ngc6589/arduinoMidiSynthPSG/Photos/20211010_050321084_iOS.jpg

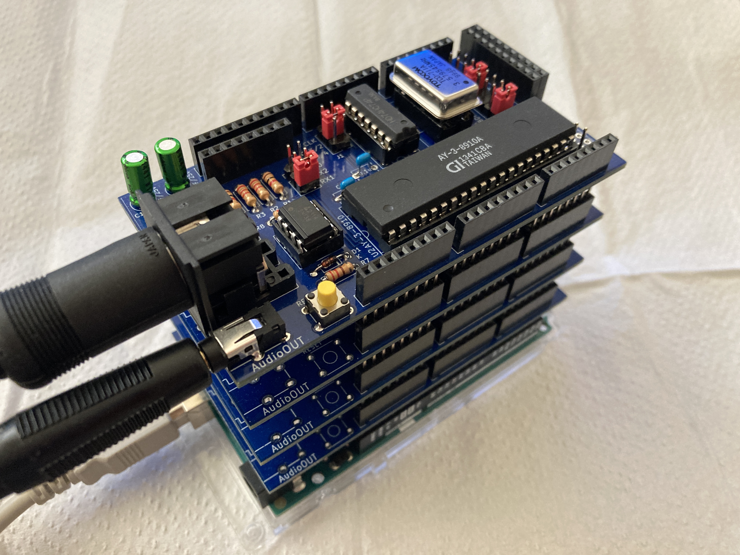
Photos/20211010_050321084_iOS.jpg
