ngc6589/arduinoMidiSynthPSG/Schematic.pdf

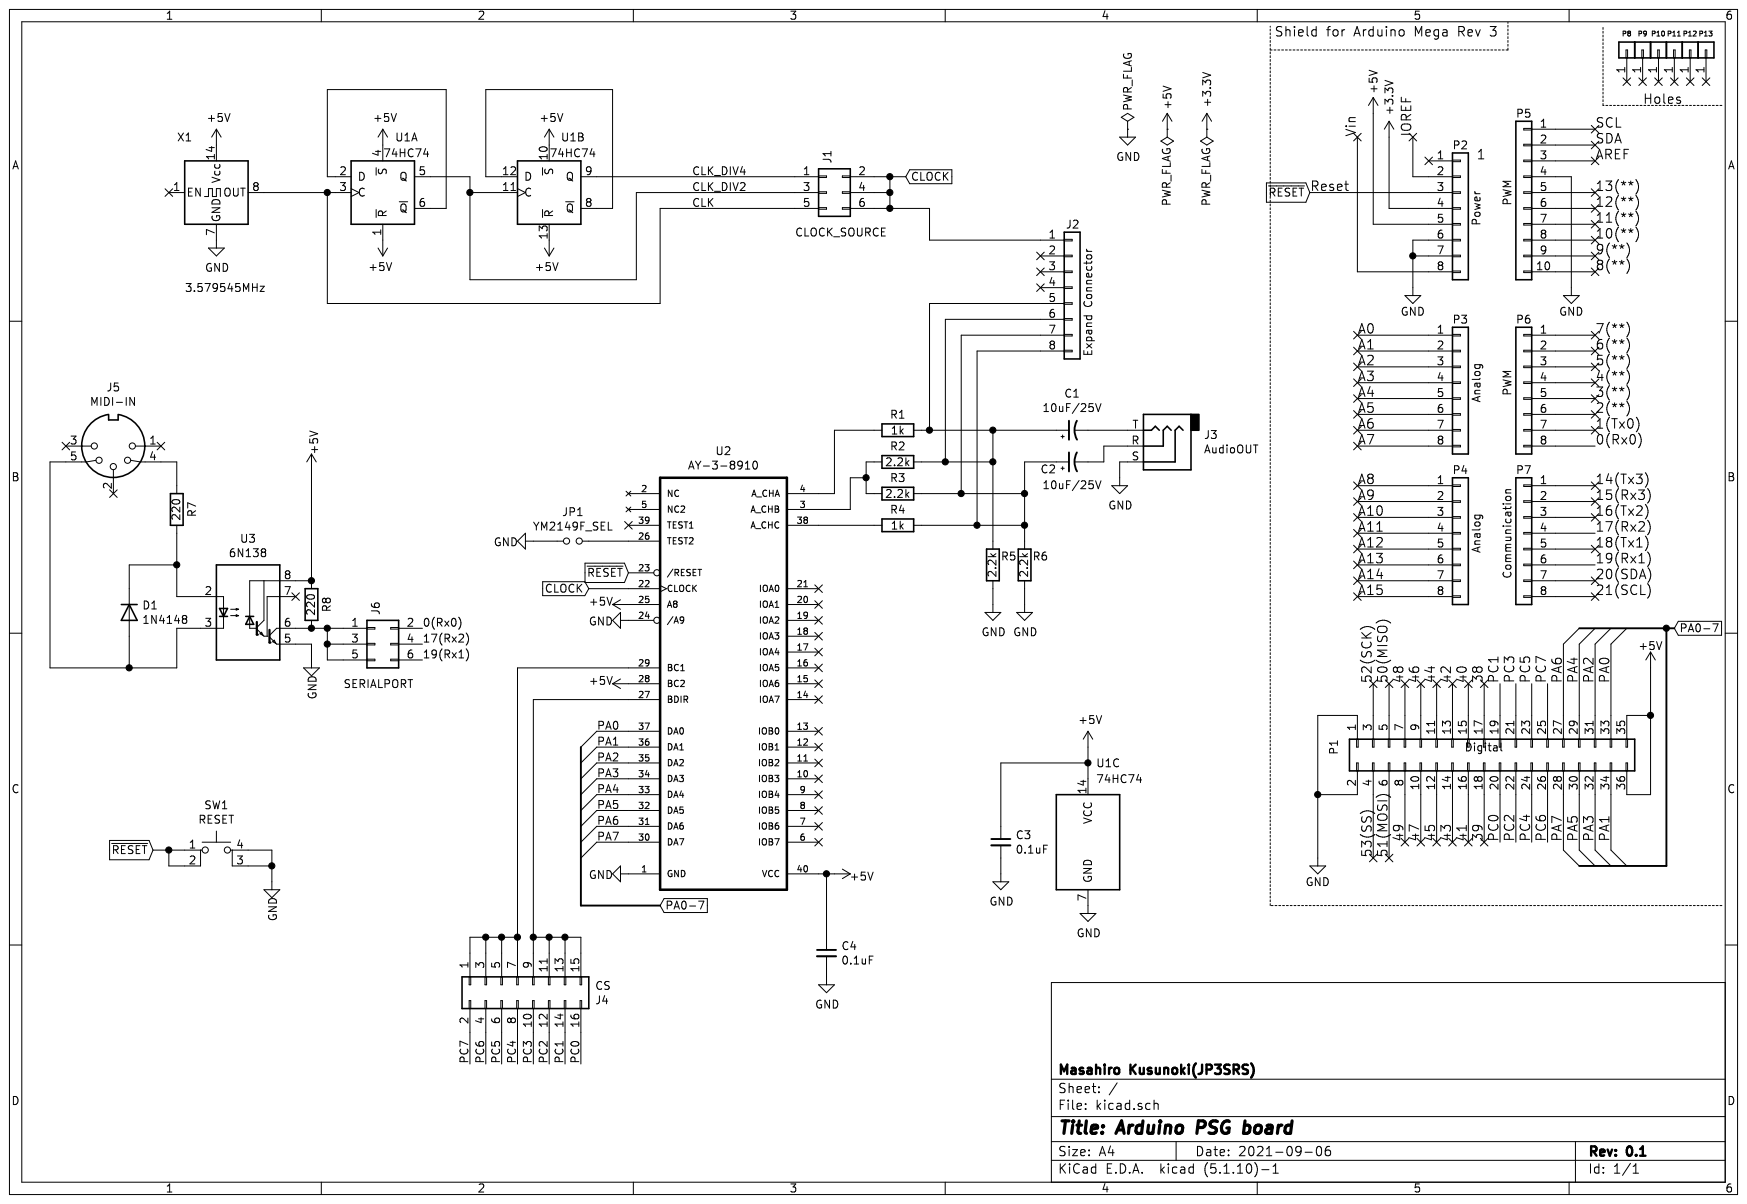
[picture p3: page 1]
