ngc6589/arduinoMidiSynthPSG/(threads)

Thread 4 (2024-07-12):

Tracing source

MiGeRA, 2024-07-12:
Hi! I am interested in your project and I intend to create it for myself! But there are some nuances that I would like to introduce into the PCB routing: please post the cad files. The result of my revision I can be issued either as a fork or as a pull request to your project ;-)

ngc6589, 2024-07-13:
I uploaded the KiCad project as a zip file.
I think the KiCad version was 5, but you should be able to open it with the latest KiCad. Please convert it to the latest version before using it.
