ngc6589/arduinoMidiSynthPSG/arduinoMidiSynthPSG/AY38910ToneValue.h

/*
 * 2021/10/10 First Written
 * Masahiro Kusunoki(JP3SRS)
 * 
 * Master Clock 3.579545MHz / 2 = 1.7897725MHz
 *
 */
#include <stdint.h>
// const uint16_t pitchValue[] PROGMEM =
const uint16_t pitchValue[] = {
  13675,
  12917,
  12185,
  11508,
  10860,
  10253,
  9677,
  9131,
  8618,
  8135,
  7677,
  7250,
  6842,
  6458,
  6096,
  5751,
  5430,
  5124,
  4838,
  4566,
  4309,
  4068,
  3839,
  3624,
  3421,
  3228,
  3047,
  2876,
  2715,
  2563,
  2419,
  2283,
  2155,
  2034,
  1920,
  1812,
  1710,
  1614,
  1524,
  1438,
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
};
