ngc6589/arduinoMidiSynthPSG/Photos/20211010_050349589_iOS.jpg

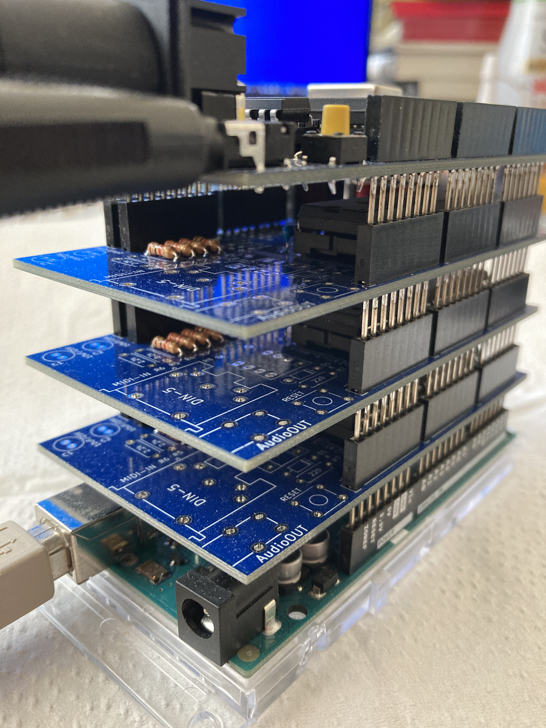
Photos/20211010_050349589_iOS.jpg
